CircusMonkey/esp32-rs232-adapter/PCB/esp32_rs232_adapter.kicad_pcb

## KiCad design PCB/esp32_rs232_adapter.kicad_pcb (2019-11-04)

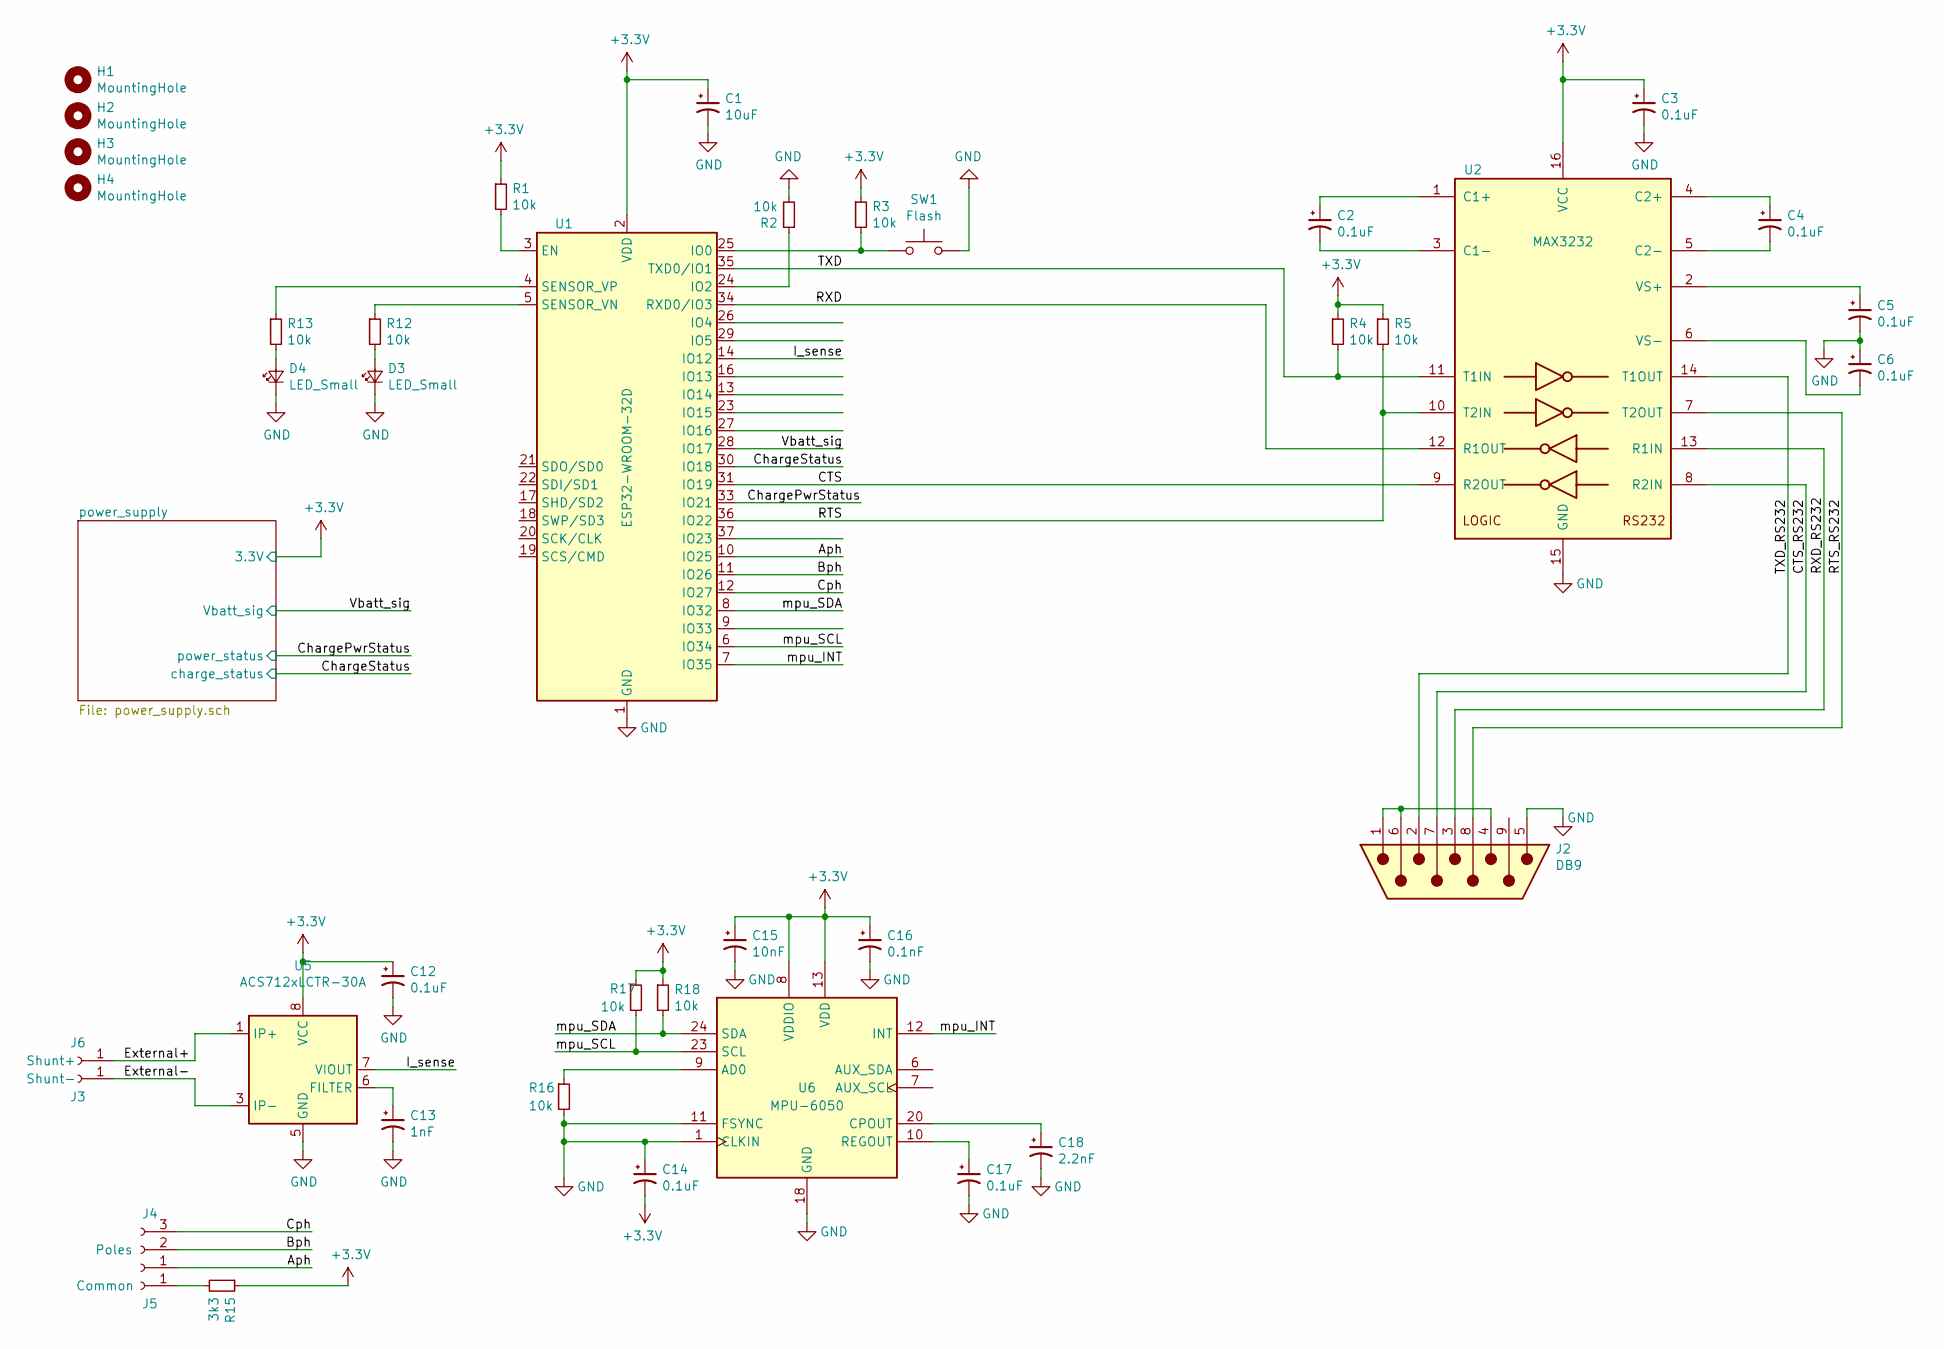
[picture p1: schematic esp32_rs232_adapter.sch]

Parts:
C1: 10uF; C_0805_2012Metric
C2, C3, C4, C5, C6, C12, C14, C17: 0.1uF; C_0805_2012Metric
C13: 1nF; C_0805_2012Metric
C15: 10nF; C_0805_2012Metric
C16: 0.1nF; C_0805_2012Metric
C18: 2.2nF; C_0805_2012Metric
D3, D4: LED_Small; LED_0805_2012Metric
H1, H2, H3, H4: MountingHole; MountingHole_3.2mm_M3_ISO7380
J2: DB9; DSUB-9_Male_Horizontal_P2.77x2.84mm_EdgePinOffset4.94mm_Hou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
J3: Shunt-; Banana_Jack_1Pin
J4: Poles; Banana_Jack_3Pin
J5: Common; Banana_Jack_1Pin
J6: Shunt+; Banana_Jack_1Pin
R1, R2, R3, R4, R5, R12, R13, R16, R17, R18: 10k; R_0805_2012Metric
R15: 3k3; R_0805_2012Metric
SW1: Flash; SW_SPST_B3S-1000
U1: ESP32-WROOM-32D; ESP32-WROOM-32-Heat
U2: MAX3232; SOP-16_4.55x10.3mm_P1.27mm
U5: ACS712xLCTR-30A; SOIC-8_3.9x4.9mm_P1.27mm
U6: MPU-6050; InvenSense_QFN-24_4x4mm_P0.5mm

Connections:
+3V3: C1.1, C3.1, C12.1, C14.2, C15.1, C16.1, R1.1, R3.1, R4.1, R5.1, R15.1, R17.1, R18.1, U1.2 (VDD), U2.16 (VCC), U5.8 (VCC), U6.8 (VDDIO), U6.13 (VDD); also elsewhere on the board
/Aph: J4.1, U1.10 (IO25)
/Bph: J4.2, U1.11 (IO26)
/CTS: U1.31 (IO19), U2.9 (R2OUT)
/CTS_RS232: J2.7, U2.8 (R2IN)
/ChargePwrStatus: U1.33 (IO21); also elsewhere on the board
/ChargeStatus: U1.30 (IO18); also elsewhere on the board
/Cph: J4.3, U1.12 (IO27)
/External+: J6.1, U5.1 (IP+), U5.2 (IP+)
/External-: J3.1, U5.3 (IP-), U5.4 (IP-)
/I_sense: U1.14 (IO12), U5.7 (VIOUT)
/RTS: R5.2, U1.36 (IO22), U2.10 (T2IN)
/RTS_RS232: J2.8, U2.7 (T2OUT)
/RXD: U1.34 (RXD0/IO3), U2.12 (R1OUT)
/RXD_RS232: J2.3, U2.13 (R1IN)
/TXD: R4.2, U1.35 (TXD0/IO1), U2.11 (T1IN)
/TXD_RS232: J2.2, U2.14 (T1OUT)
/Vbatt_sig: U1.28 (IO17); also elsewhere on the board
/mpu_INT: U1.7 (IO35), U6.12 (INT)
/mpu_SCL: R17.2, U1.6 (IO34), U6.23 (SCL)
/mpu_SDA: R18.2, U1.8 (IO32), U6.24 (SDA)
GND: C1.2, C3.2, C5.2, C6.1, C12.2, C13.2, C14.1, C15.2, C16.2, C17.2, C18.2, D3.1 (K), D4.1 (K), J2.5, R2.2, R16.2, SW1.2, U1.1 (GND), U1.15 (GND), U1.38 (GND), U2.15 (GND), U5.5 (GND), U6.1 (CLKIN), U6.11 (FSYNC), U6.18 (GND); also elsewhere on the board
unnamed: C2.1, U2.1 (C1+)
unnamed: C2.2, U2.3 (C1-)
unnamed: C4.1, U2.4 (C2+)
unnamed: C4.2, U2.5 (C2-)
unnamed: C5.1, U2.2 (VS+)
unnamed: C6.2, U2.6 (VS-)
unnamed: C13.1, U5.6 (FILTER)
unnamed: C17.1, U6.10 (REGOUT)
unnamed: C18.1, U6.20 (CPOUT)
unnamed: D3.2 (A), R12.2
unnamed: D4.2 (A), R13.2
unnamed: J2.1, J2.4, J2.6
unnamed: J5.1, R15.2
unnamed: R1.2, U1.3 (EN)
unnamed: R2.1, U1.24 (IO2)
unnamed: R3.2, SW1.1, U1.25 (IO0)
unnamed: R12.1, U1.5 (SENSOR_VN)
unnamed: R13.1, U1.4 (SENSOR_VP)
unnamed: R16.1, U6.9 (AD0)

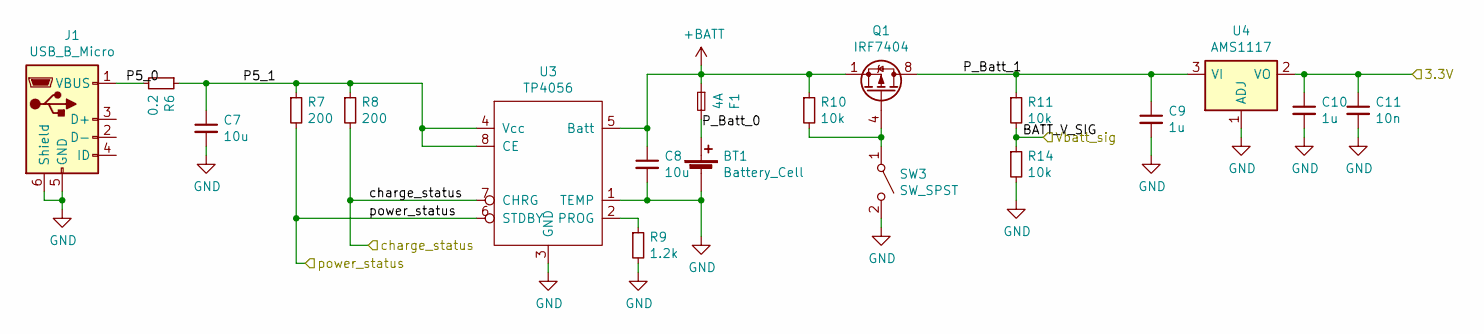
[picture p2: schematic power_supply.sch]

Parts:
BT1: Battery_Cell; JST_PH_B2B-PH-K_1x02_P2.00mm_Vertical
C7, C8: 10u; C_0805_2012Metric
C9, C10: 1u; C_0805_2012Metric
C11: 10n; C_0805_2012Metric
F1: 4A; Fuse_1206_3216Metric
J1: USB_B_Micro; USB_Micro-B_Molex-105017-0001
Q1: IRF7404; SOIC-8_3.9x4.9mm_P1.27mm
R6: 0.2; R_0805_2012Metric
R7, R8: 200; R_0805_2012Metric
R9: 1.2k; R_0805_2012Metric
R10, R11, R14: 10k; R_0805_2012Metric
SW3: SW_SPST; SW_CuK_JS202011CQN_DPDT_Straight
U3: TP4056; SSOP-8_3.9x5.05mm_P1.27mm
U4: AMS1117; SOT-223-3_TabPin2

Connections:
+3V3: C10.1, C11.1, U4.2 (VO); also elsewhere on the board
+BATT: C8.1, F1.1, Q1.1 (S), Q1.2 (S), Q1.3 (S), R10.1, U3.5 (Batt)
/ChargePwrStatus: R7.2, U3.6 (STDBY); also elsewhere on the board
/ChargeStatus: R8.2, U3.7 (CHRG); also elsewhere on the board
/Vbatt_sig: R11.2, R14.1; also elsewhere on the board
/power_supply/P5_0: J1.1 (VBUS), R6.2
/power_supply/P5_1: C7.1, R6.1, R7.1, R8.1, U3.4 (Vcc), U3.8 (CE)
/power_supply/P_Batt_0: BT1.1 (+), F1.2
/power_supply/P_Batt_1: C9.1, Q1.5 (D), Q1.6 (D), Q1.7 (D), Q1.8 (D), R11.1, U4.3 (VI)
GND: BT1.2 (-), C7.2, C8.2, C9.2, C10.2, C11.2, J1.5 (GND), J1.6 (Shield), R9.2, R14.2, SW3.2 (B), U3.1 (TEMP), U3.3 (GND), U4.1 (ADJ); also elsewhere on the board
unnamed: Q1.4 (G), R10.2, SW3.1 (A)
unnamed: R9.1, U3.2 (PROG)

Board: 2 copper layers, 59 parts (16 on the bottom side), 48 nets, no tracks yet.
