CircusMonkey/esp32-rs232-adapter/(commit log)

2019-02-26 Starting PCB
    [esp32_rs232_adapter.kicad_pcb, esp32_rs232_adapter.sch]
2019-03-03 work on schematics
    [esp32_rs232_adapter.sch, power_supply.sch]
2019-03-04 Nearly finished schematic
    [esp32_rs232_adapter.kicad_pcb, esp32_rs232_adapter.sch, power_supply.sch]
2019-03-13 change footprints. Add dip switch for null modem
    [esp32_rs232_adapter.kicad_pcb, esp32_rs232_adapter.sch, power_supply.sch]
2019-03-13 More footprint swaps
    [esp32_rs232_adapter.kicad_pcb]
2019-03-24 PCB finished
    [esp32_rs232_adapter-B.Cu.gbl, esp32_rs232_adapter-B.Mask.gbs, esp32_rs232_adapter-B.Paste.gbp, esp32_rs232_adapter-B.SilkS.gbo, esp32_rs232_adapter-Edge.Cuts.gm1, esp32_rs232_adapter-F.Cu.gtl, esp32_rs232_adapter-F.Mask.gts, esp32_rs232_adapter-F.Paste.gtp]
2019-03-24 Forgot to save before committing last time :|
    [esp32_rs232_adapter.kicad_pcb]
2019-03-24 remove via in through hole
    [esp32_rs232_adapter-B.Cu.gbl, esp32_rs232_adapter-B.Mask.gbs, esp32_rs232_adapter-B.Paste.gbp, esp32_rs232_adapter-B.SilkS.gbo, esp32_rs232_adapter-Edge.Cuts.gm1, esp32_rs232_adapter-F.Cu.gtl, esp32_rs232_adapter-F.Mask.gts, esp32_rs232_adapter-F.Paste.gtp]
2019-04-30 work in progress with stuff for cb testing
    [esp32_rs232_adapter.kicad_pcb, esp32_rs232_adapter.sch, power_supply.sch]
2019-05-11 Updated pin assignments
    [esp32_rs232_adapter.kicad_pcb, esp32_rs232_adapter.sch]
2019-11-04 remove null modem switch
    [esp32_rs232_adapter.kicad_pcb, esp32_rs232_adapter.sch, power_supply.sch]
